aiast1/Hybrid-Solar-Thermoelectric-Power-Generation-System-with-Magneto-Hydrodynamic-Propulsion/README.md

# Hybrid-Solar-Thermoelectric-Power-Generation-System-with-Magneto-Hydrodynamic-Propulsion
Development and Evaluation of a Hybrid Solar-Thermoelectric Power Generation System with Magneto-Hydrodynamic Propulsion in a Maritime Environment
