aiast1/Hybrid-Solar-Thermoelectric-Power-Generation-System-with-Magneto-Hydrodynamic-Propulsion/Poster1b.pdf

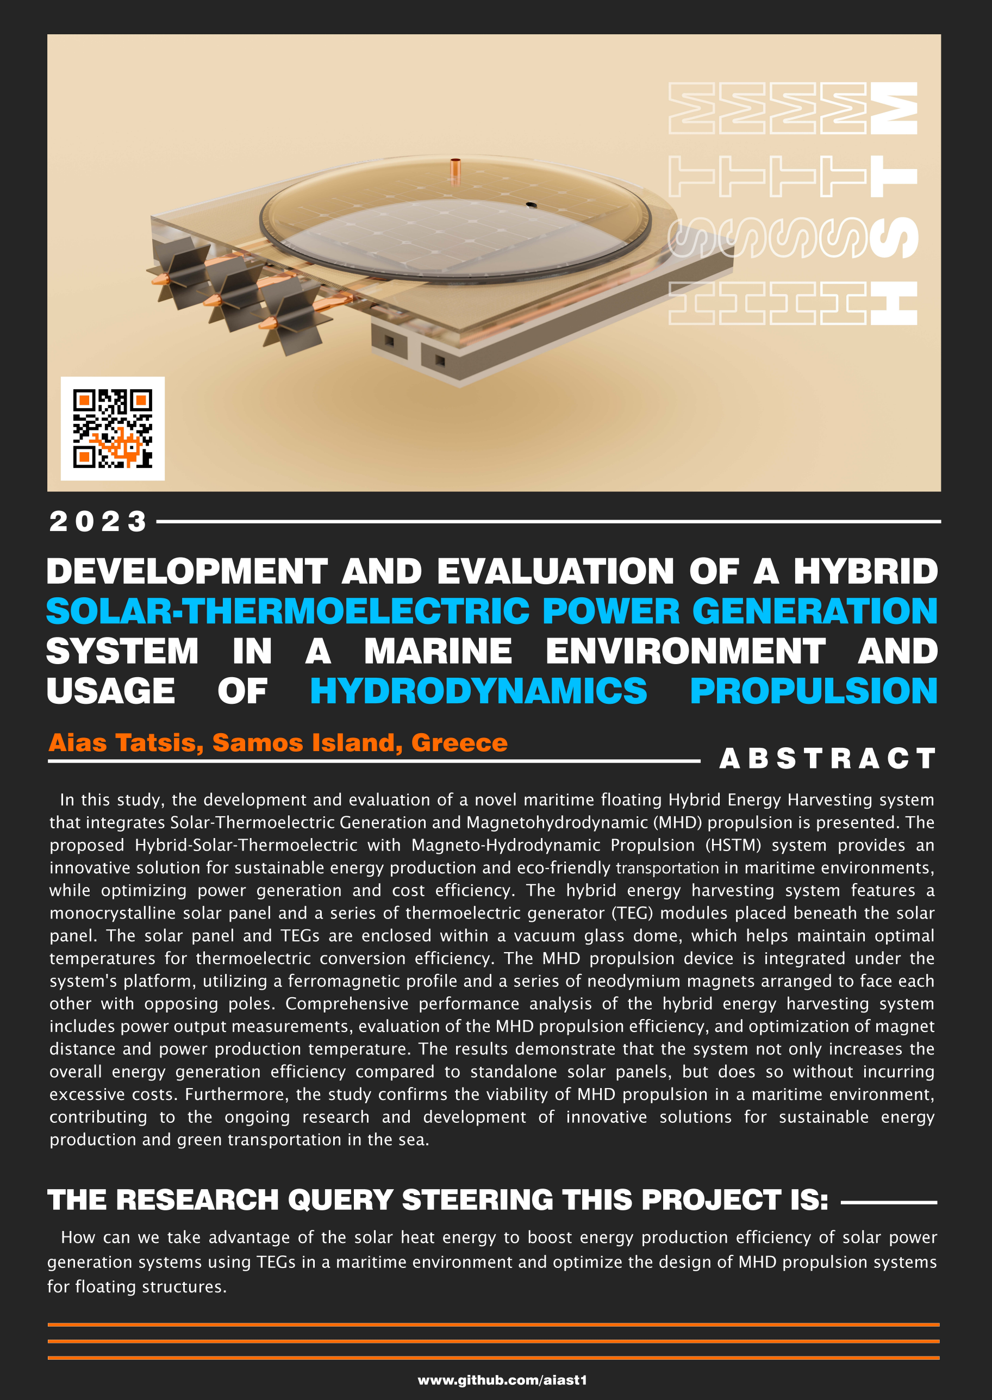
[picture p12: page 1]
