aiast1/Hybrid-Solar-Thermoelectric-Power-Generation-System-with-Magneto-Hydrodynamic-Propulsion/cad/eucys1.pdf

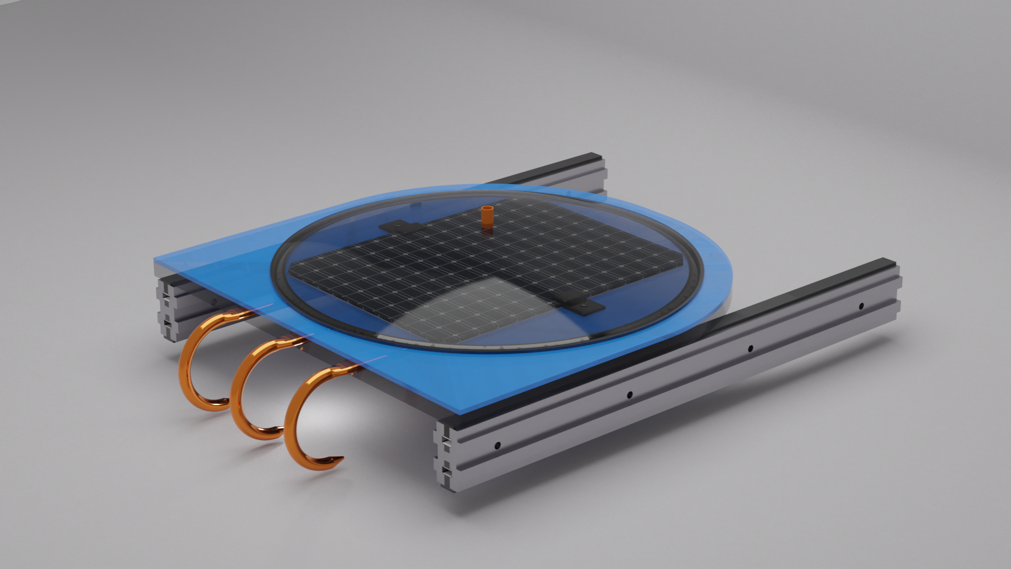
[picture p22: page 1]
