aiast1/Hybrid-Solar-Thermoelectric-Power-Generation-System-with-Magneto-Hydrodynamic-Propulsion/abstract/ABSTRACTS1.jpg

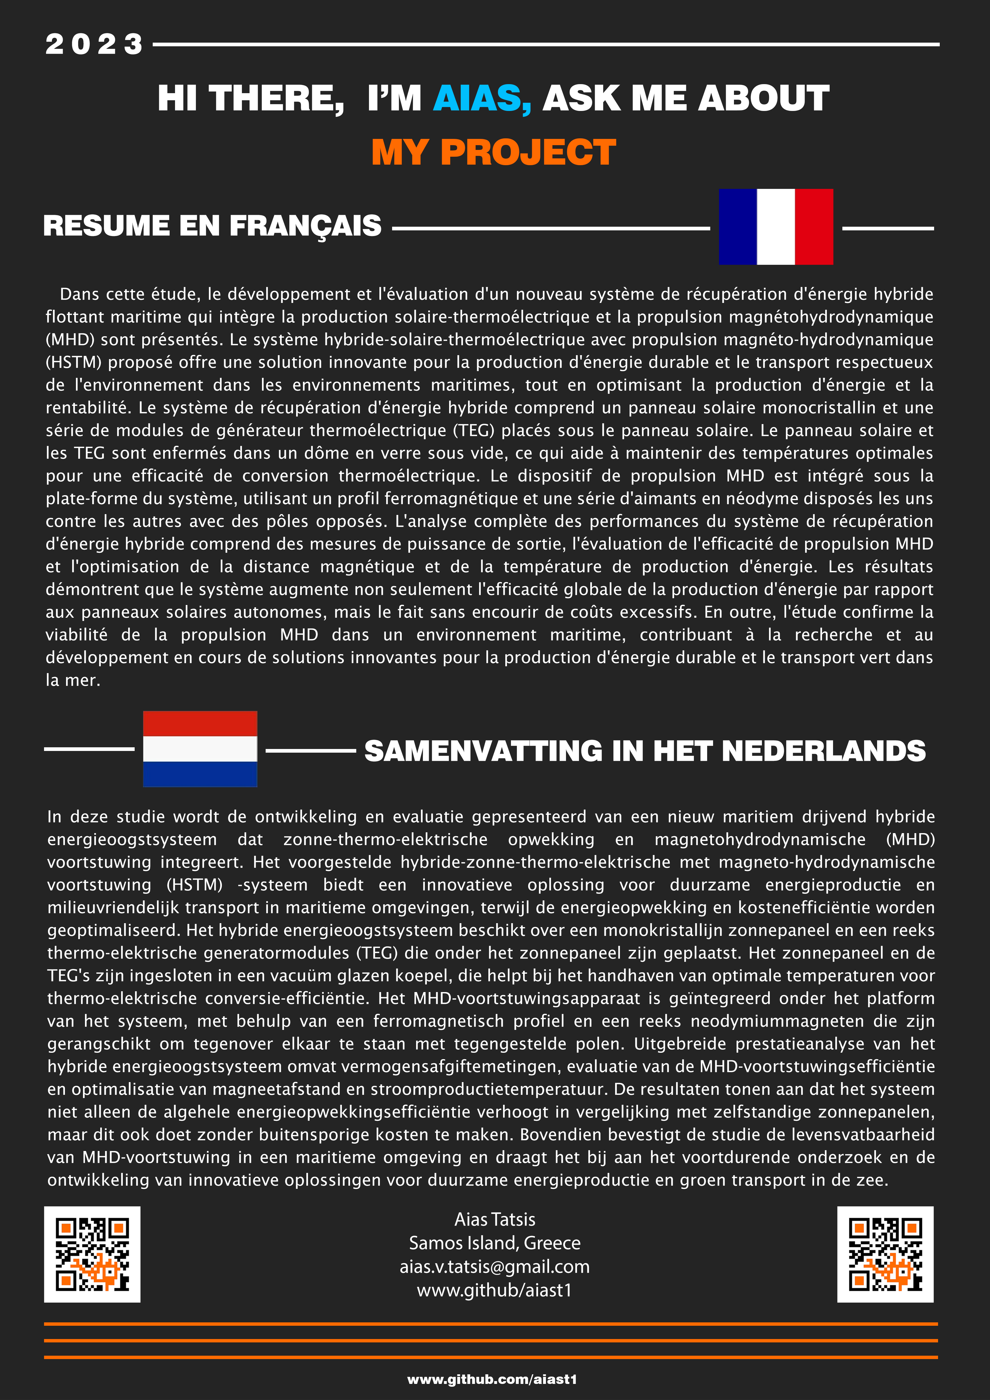
abstract/ABSTRACTS1.jpg
