aiast1/Hybrid-Solar-Thermoelectric-Power-Generation-System-with-Magneto-Hydrodynamic-Propulsion/abstract/ABSTRACTS2.jpg

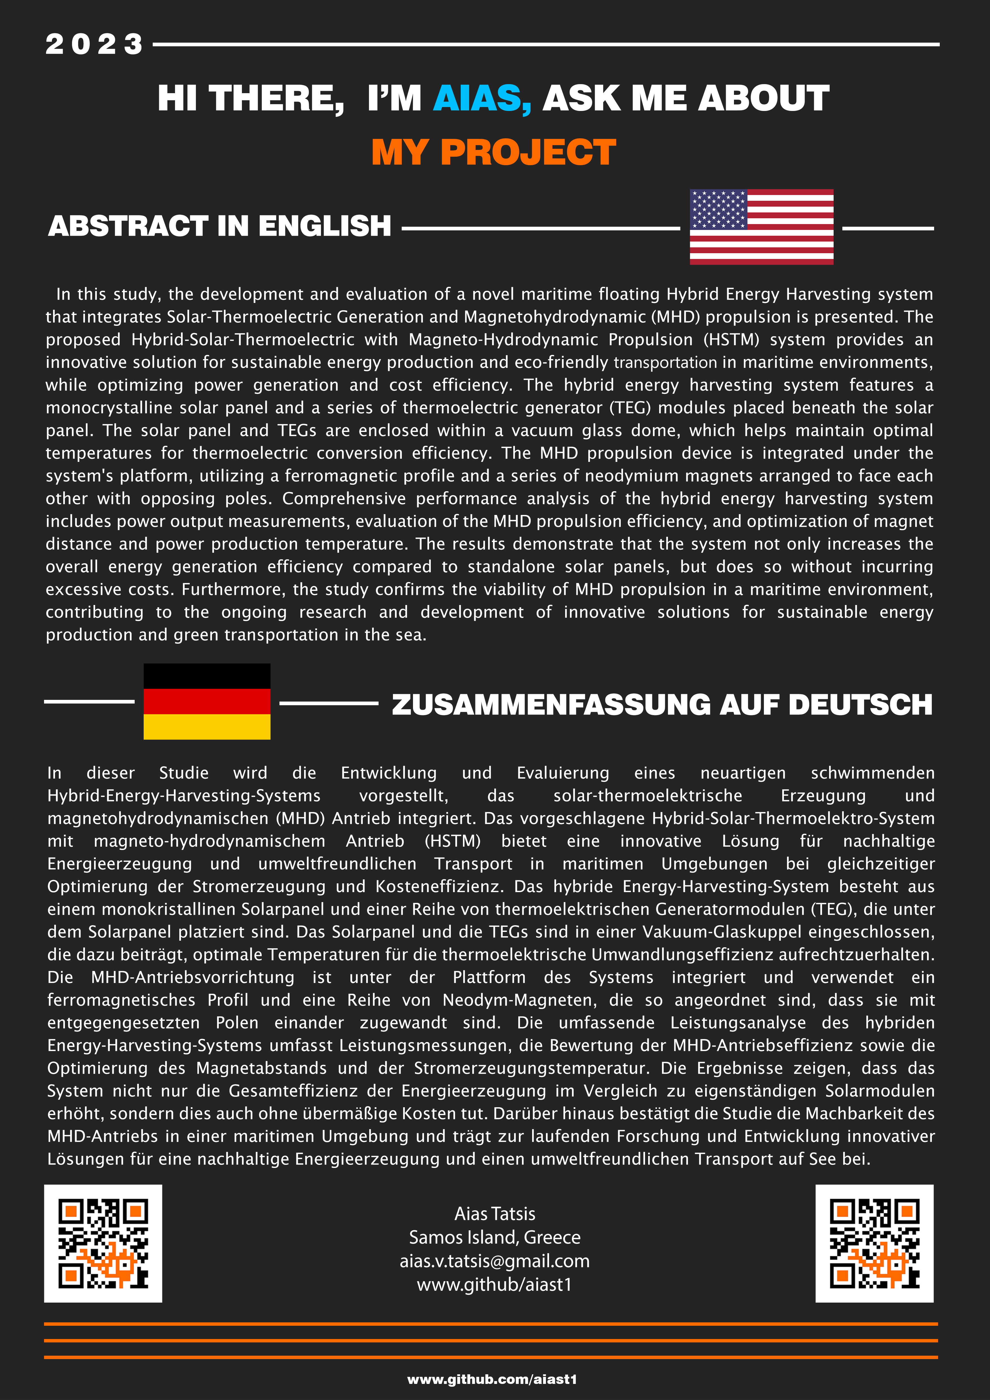
abstract/ABSTRACTS2.jpg
