aiast1/Hybrid-Solar-Thermoelectric-Power-Generation-System-with-Magneto-Hydrodynamic-Propulsion/cad/magneto_1680695830.jpg

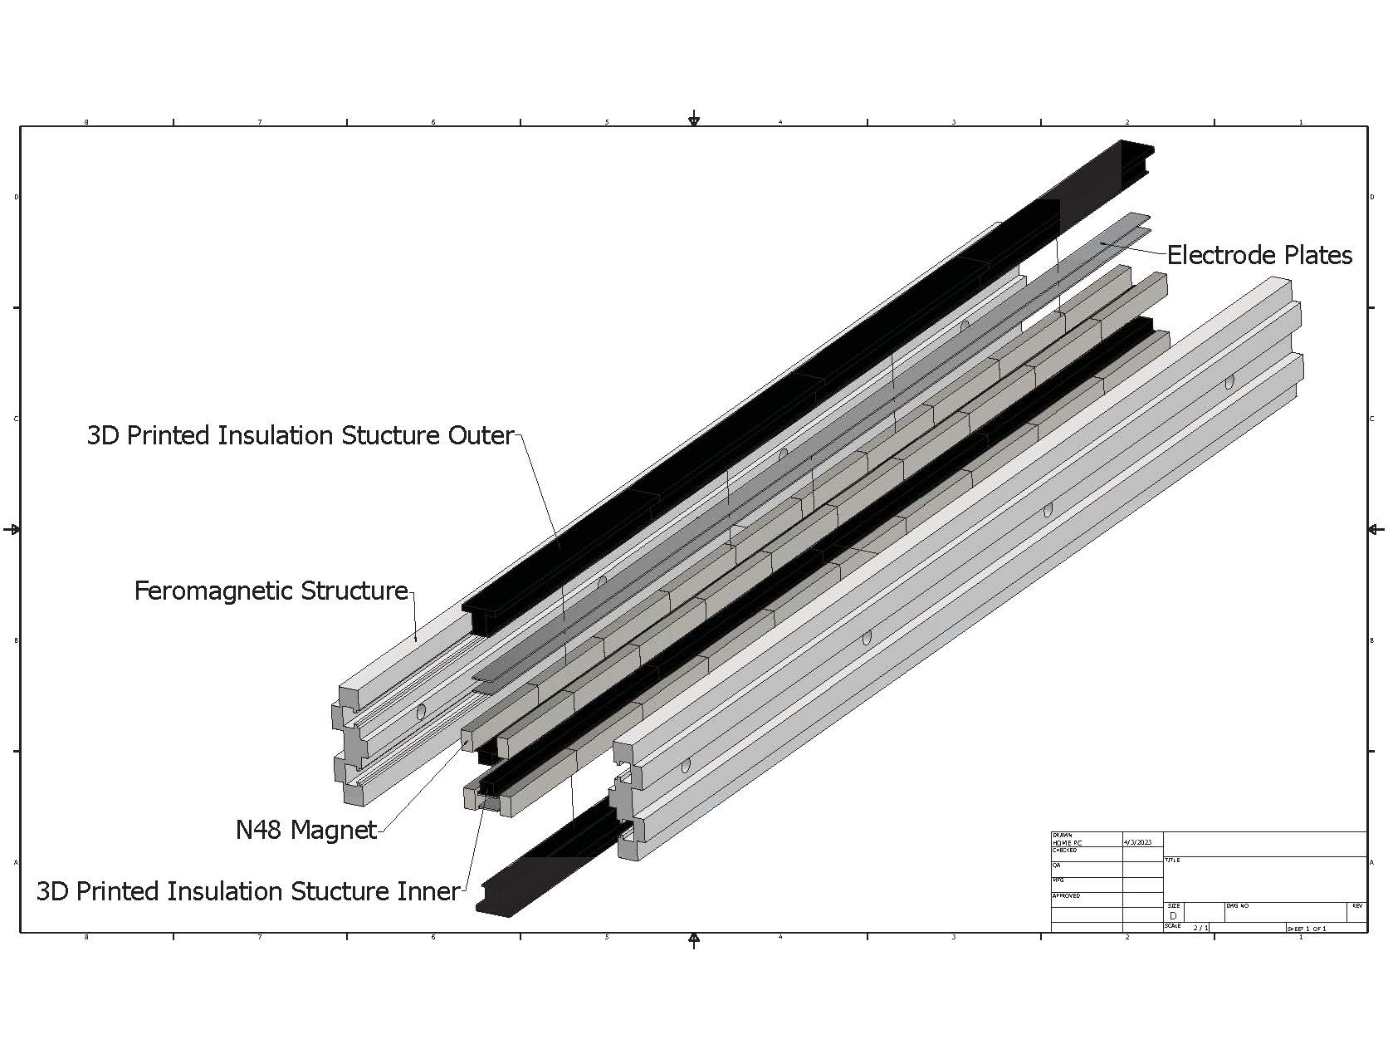
cad/magneto_1680695830.jpg
