aiast1/Hybrid-Solar-Thermoelectric-Power-Generation-System-with-Magneto-Hydrodynamic-Propulsion/efficiency heatpipes sink.png

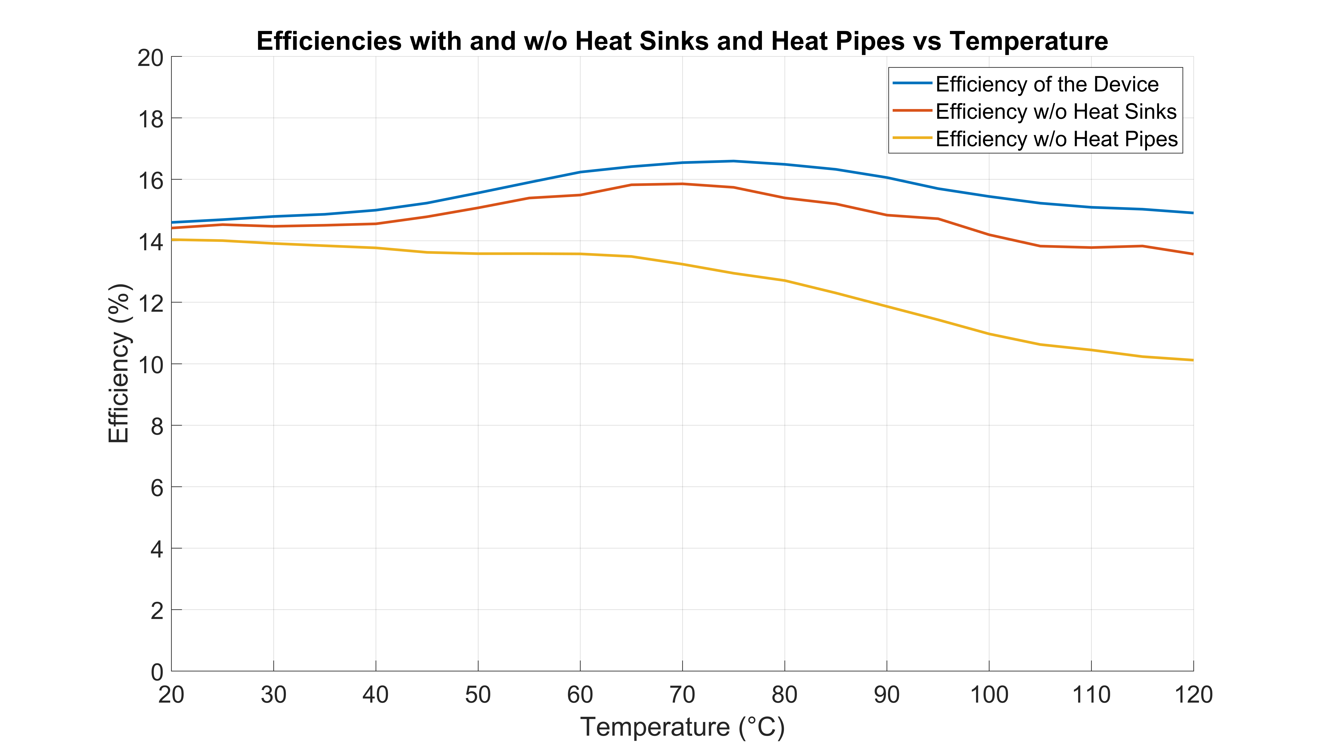
efficiency heatpipes sink.png
