aiast1/Hybrid-Solar-Thermoelectric-Power-Generation-System-with-Magneto-Hydrodynamic-Propulsion/photos/CAD/IMG_20230319_111036.jpg

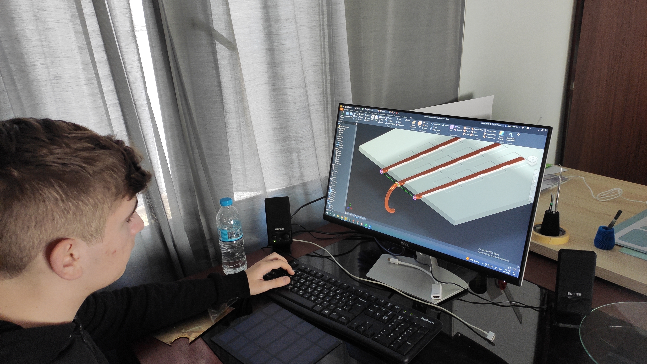
photos/CAD/IMG_20230319_111036.jpg
