aiast1/Hybrid-Solar-Thermoelectric-Power-Generation-System-with-Magneto-Hydrodynamic-Propulsion/photos/IMG_20230312_101846.jpg

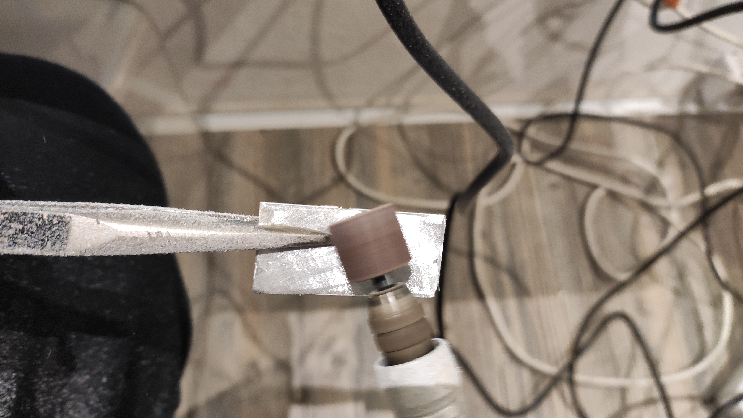
photos/IMG_20230312_101846.jpg
