aiast1/Hybrid-Solar-Thermoelectric-Power-Generation-System-with-Magneto-Hydrodynamic-Propulsion/photos/IMG_20230312_110155.jpg

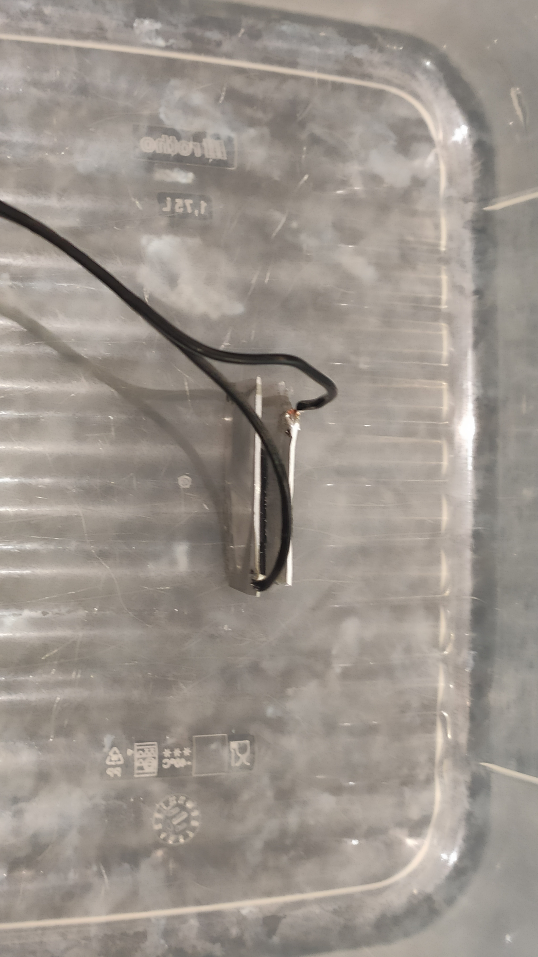
photos/IMG_20230312_110155.jpg
