aiast1/Hybrid-Solar-Thermoelectric-Power-Generation-System-with-Magneto-Hydrodynamic-Propulsion/photos/IMG_20230318_114442_1.jpg

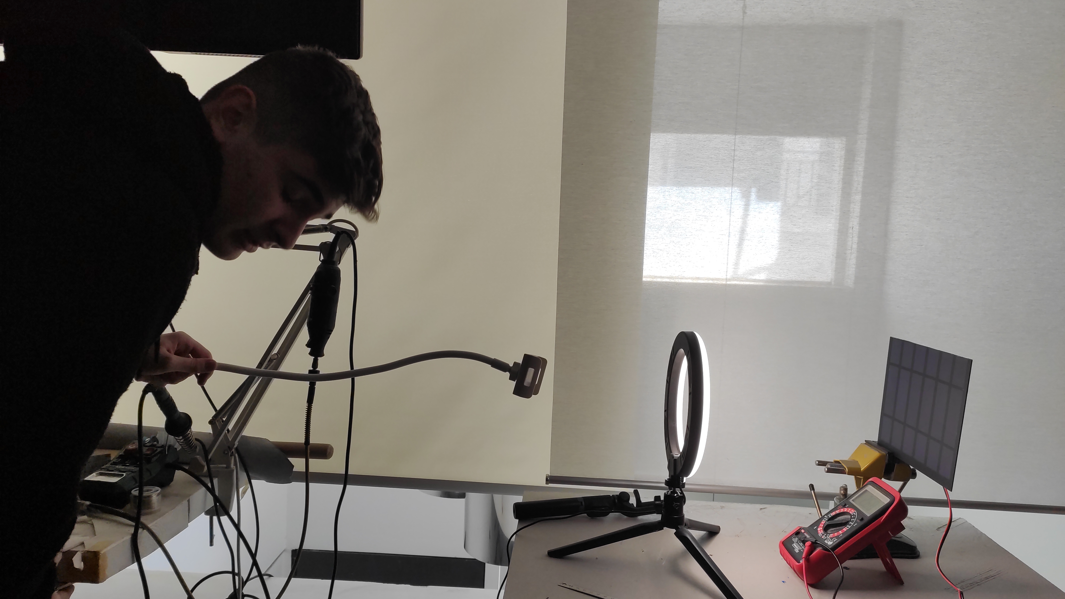
photos/IMG_20230318_114442_1.jpg
