aiast1/Hybrid-Solar-Thermoelectric-Power-Generation-System-with-Magneto-Hydrodynamic-Propulsion/speed vs voltage.PNG

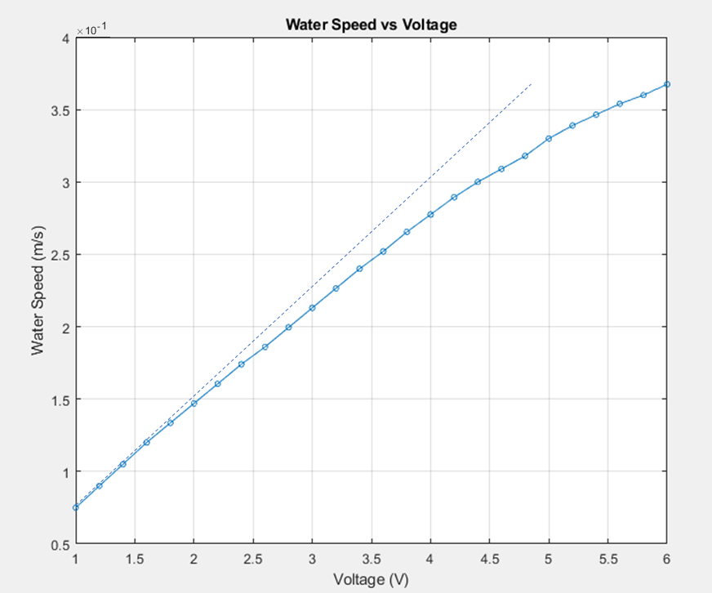
speed vs voltage.PNG
