aiast1/Hybrid-Solar-Thermoelectric-Power-Generation-System-with-Magneto-Hydrodynamic-Propulsion/TEG vs T vs Solar.png

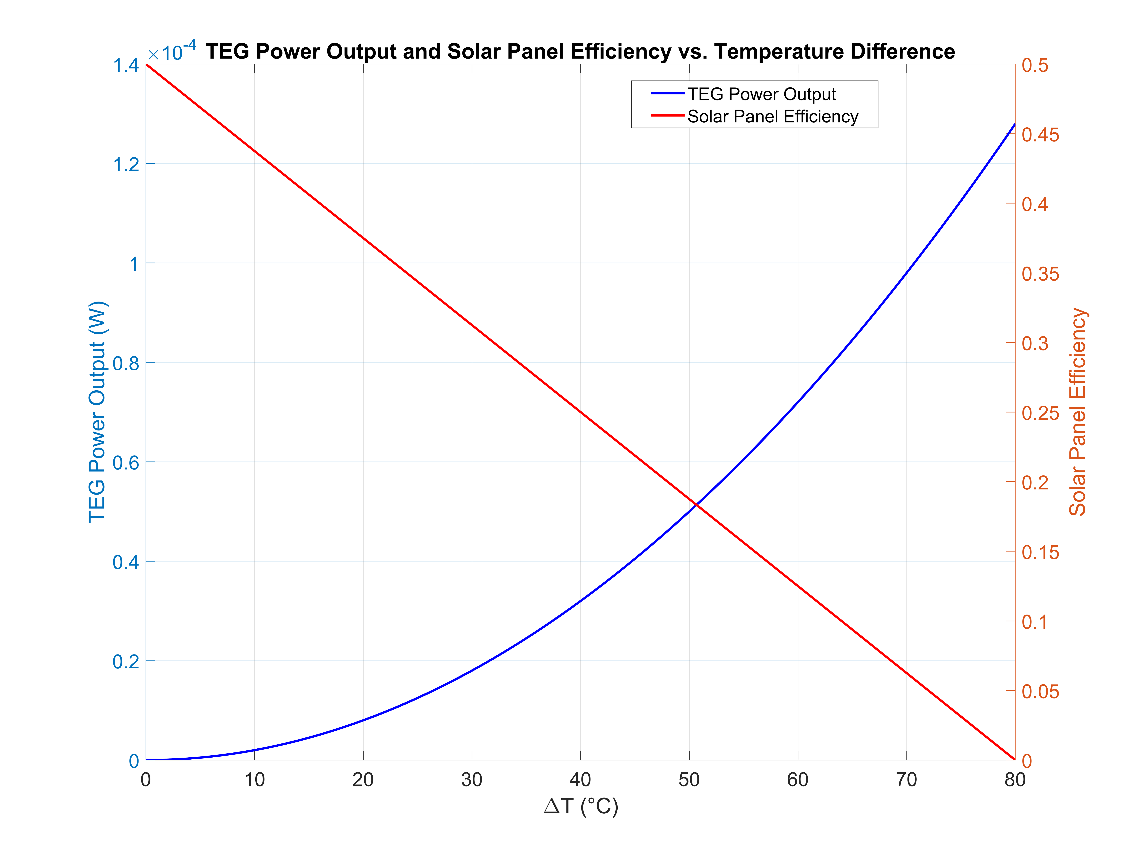
TEG vs T vs Solar.png
