aiast1/Hybrid-Solar-Thermoelectric-Power-Generation-System-with-Magneto-Hydrodynamic-Propulsion/cad/magnets nest half.stl

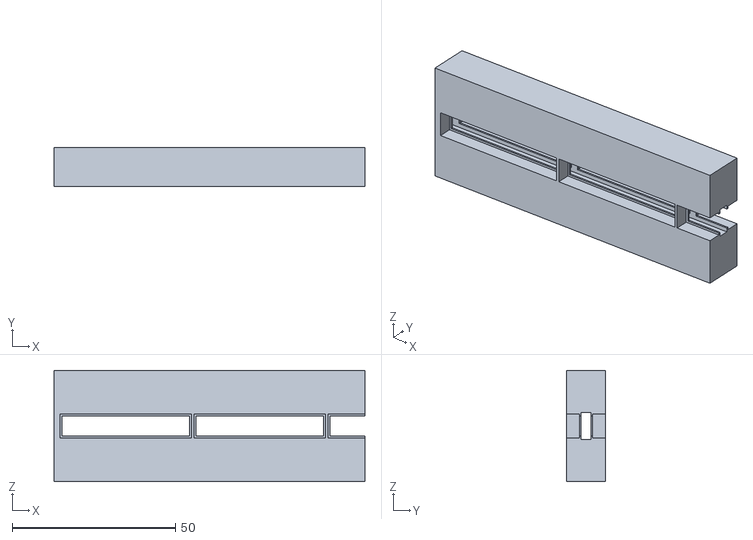
[picture p67: CAD file, 2023-09-13]
cad/magnets nest half.stl
95.2 x 12.0 x 34.0
