aiast1/Hybrid-Solar-Thermoelectric-Power-Generation-System-with-Magneto-Hydrodynamic-Propulsion/(list of files, cad)

Other CAD files:
cad/PLEXI 10 MM 3.dwg
cad/STEG.ipt
cad/magnets nest half.ipt
cad/magnets nest.ipt
