aiast1/Hybrid-Solar-Thermoelectric-Power-Generation-System-with-Magneto-Hydrodynamic-Propulsion/photos/assembly/IMG_20230330_202559.jpg

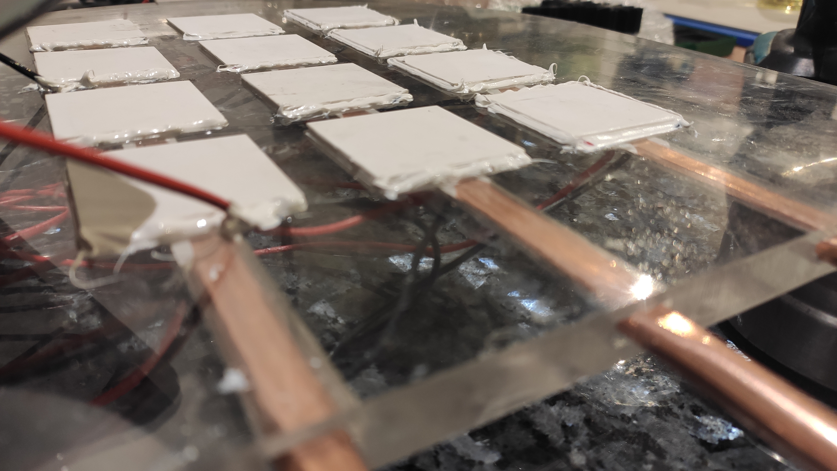
photos/assembly/IMG_20230330_202559.jpg
