aiast1/Hybrid-Solar-Thermoelectric-Power-Generation-System-with-Magneto-Hydrodynamic-Propulsion/photos/assembly/IMG_20230401_193739.jpg

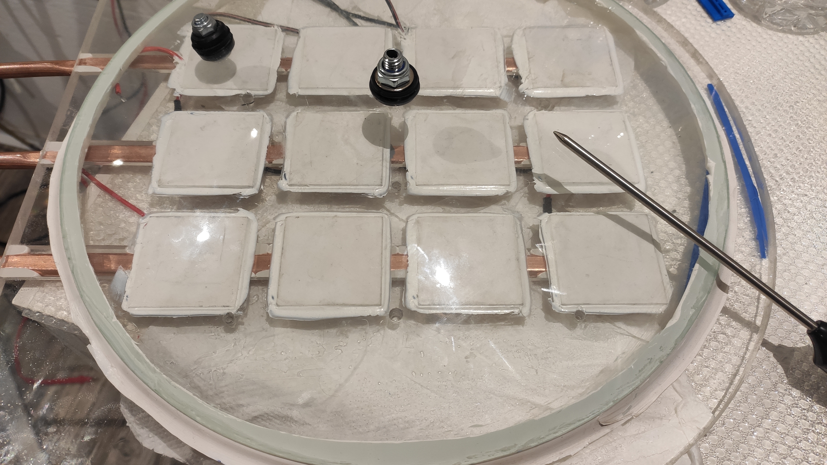
photos/assembly/IMG_20230401_193739.jpg
