aiast1/Hybrid-Solar-Thermoelectric-Power-Generation-System-with-Magneto-Hydrodynamic-Propulsion/photos/construction/IMG_20230328_185858.jpg

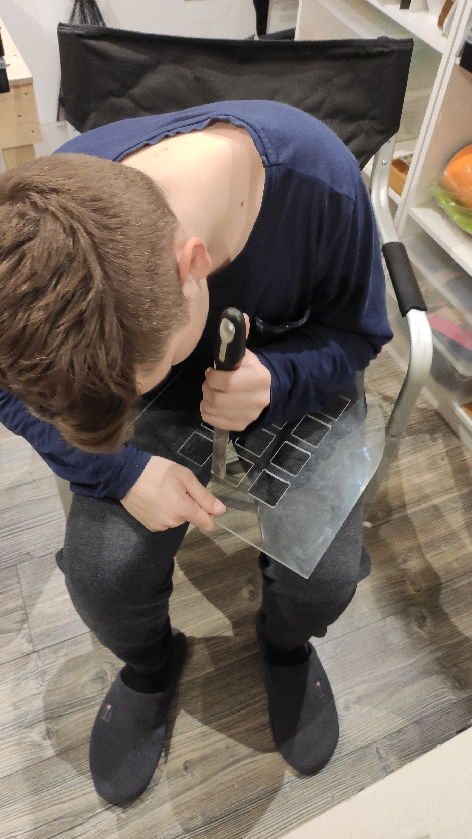
photos/construction/IMG_20230328_185858.jpg
