aiast1/Hybrid-Solar-Thermoelectric-Power-Generation-System-with-Magneto-Hydrodynamic-Propulsion/photos/construction/IMG_20230330_120338.jpg

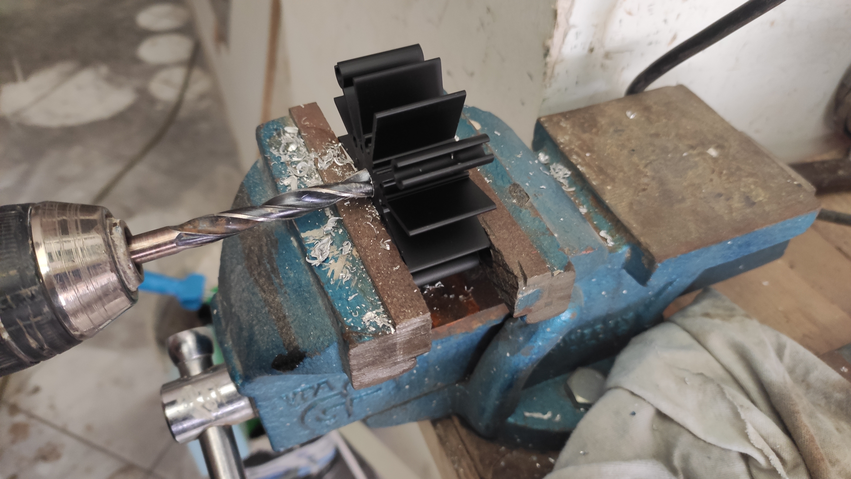
photos/construction/IMG_20230330_120338.jpg
