aiast1/Hybrid-Solar-Thermoelectric-Power-Generation-System-with-Magneto-Hydrodynamic-Propulsion/photos/testing/IMG_20230430_141038 - Copy.jpg

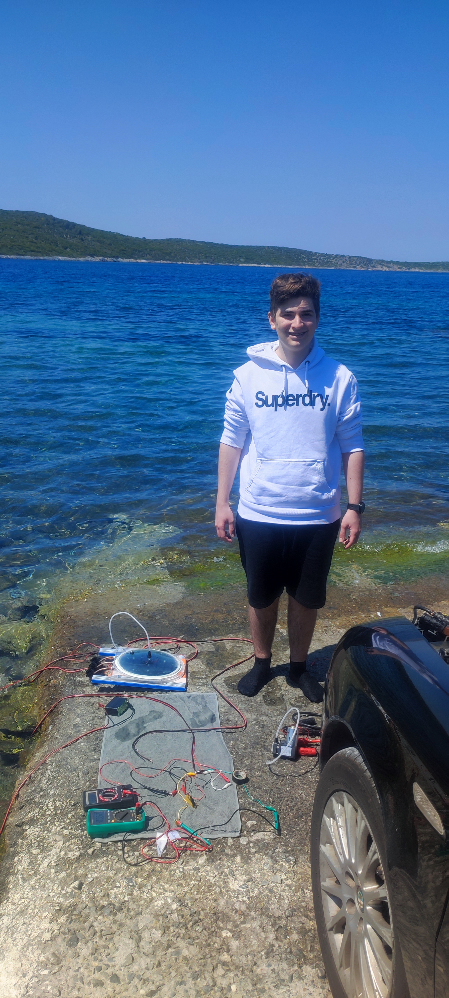
photos/testing/IMG_20230430_141038 - Copy.jpg
