aiast1/Hybrid-Solar-Thermoelectric-Power-Generation-System-with-Magneto-Hydrodynamic-Propulsion/cad/project design.pdf

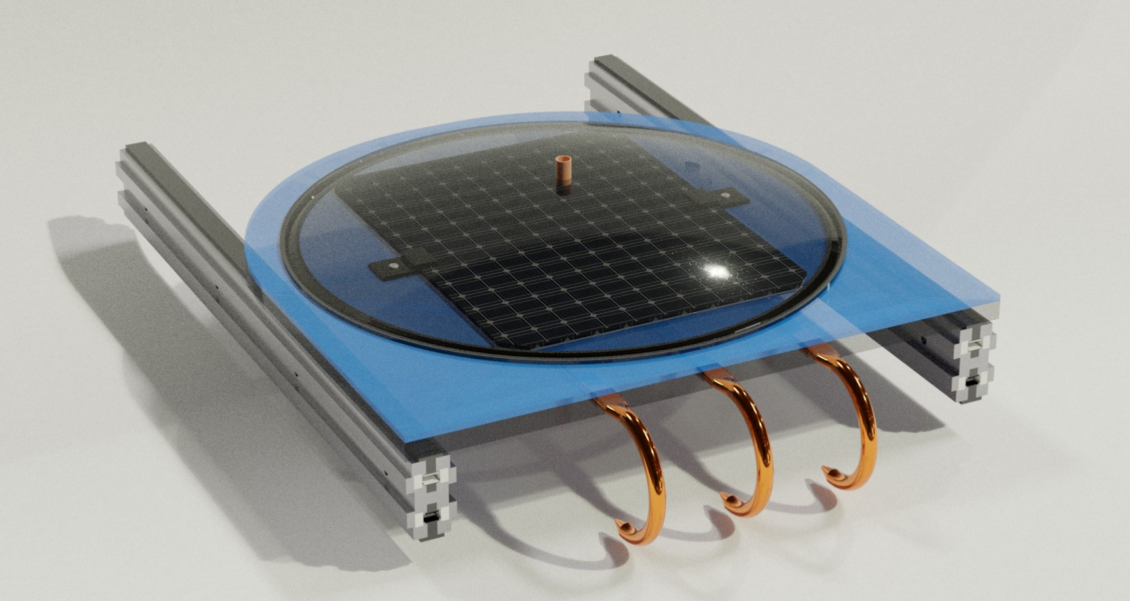
[picture p120: page 1]
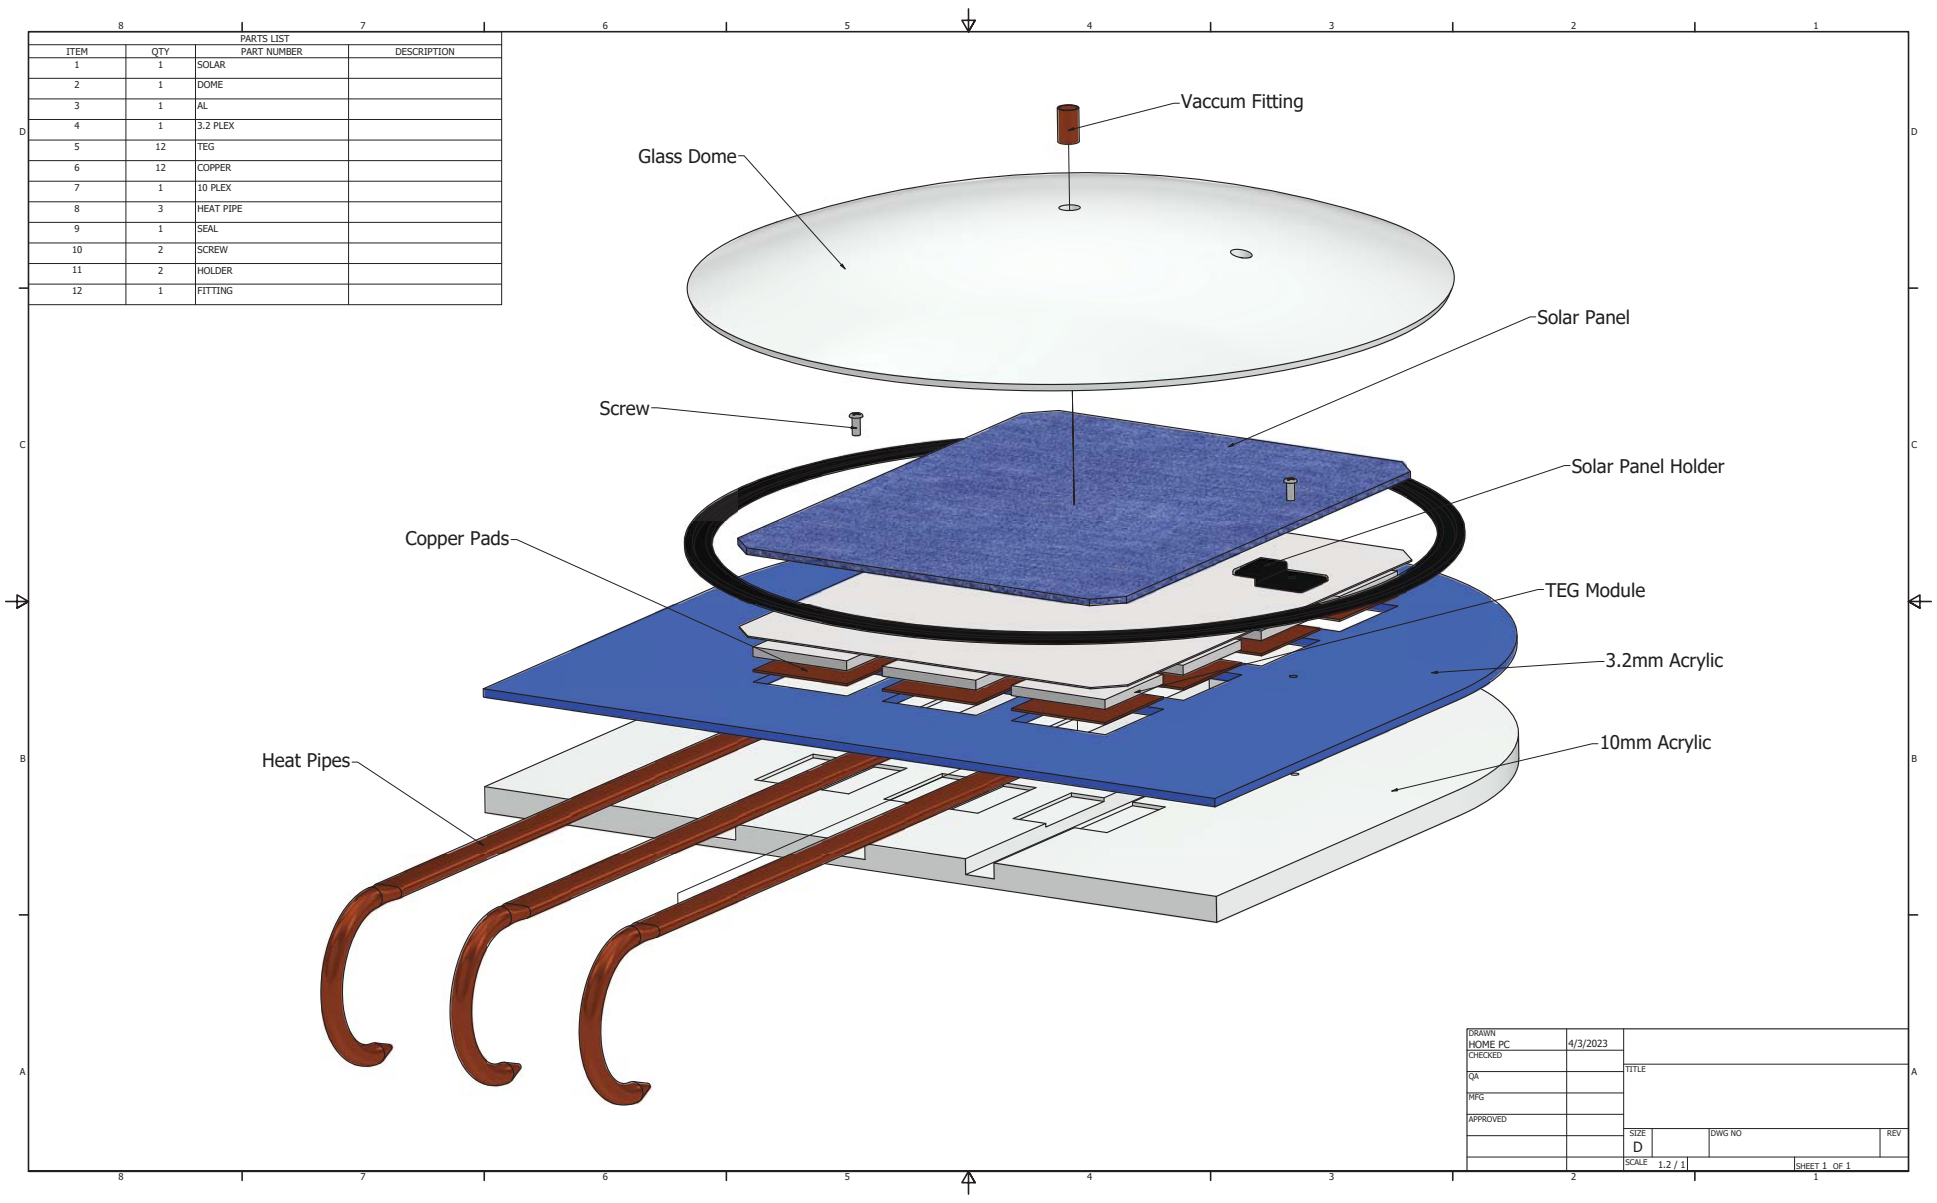
[picture p121: page 2]
PARTS LIST; ITEM; QTY; PART NUMBER; DESCRIPTION; SOLAR; DOME; 3.2 PLEX; TEG; COPPER; 10 PLEX; HEAT PIPE; SEAL; SCREW; HOLDER; FITTING; SHEET 1 OF 1; DRAWN; CHECKED; MFG; APPROVED; HOME PC; DWG NO; TITLE; SIZE D; SCALE; REV; Glass Dome; Vaccum Fitting; Screw; Solar Panel; Copper Pads; TEG Module; 3.2mm Acrylic; 10mm Acrylic; Heat Pipes

Solar Panel Holder

# Electrode Plates

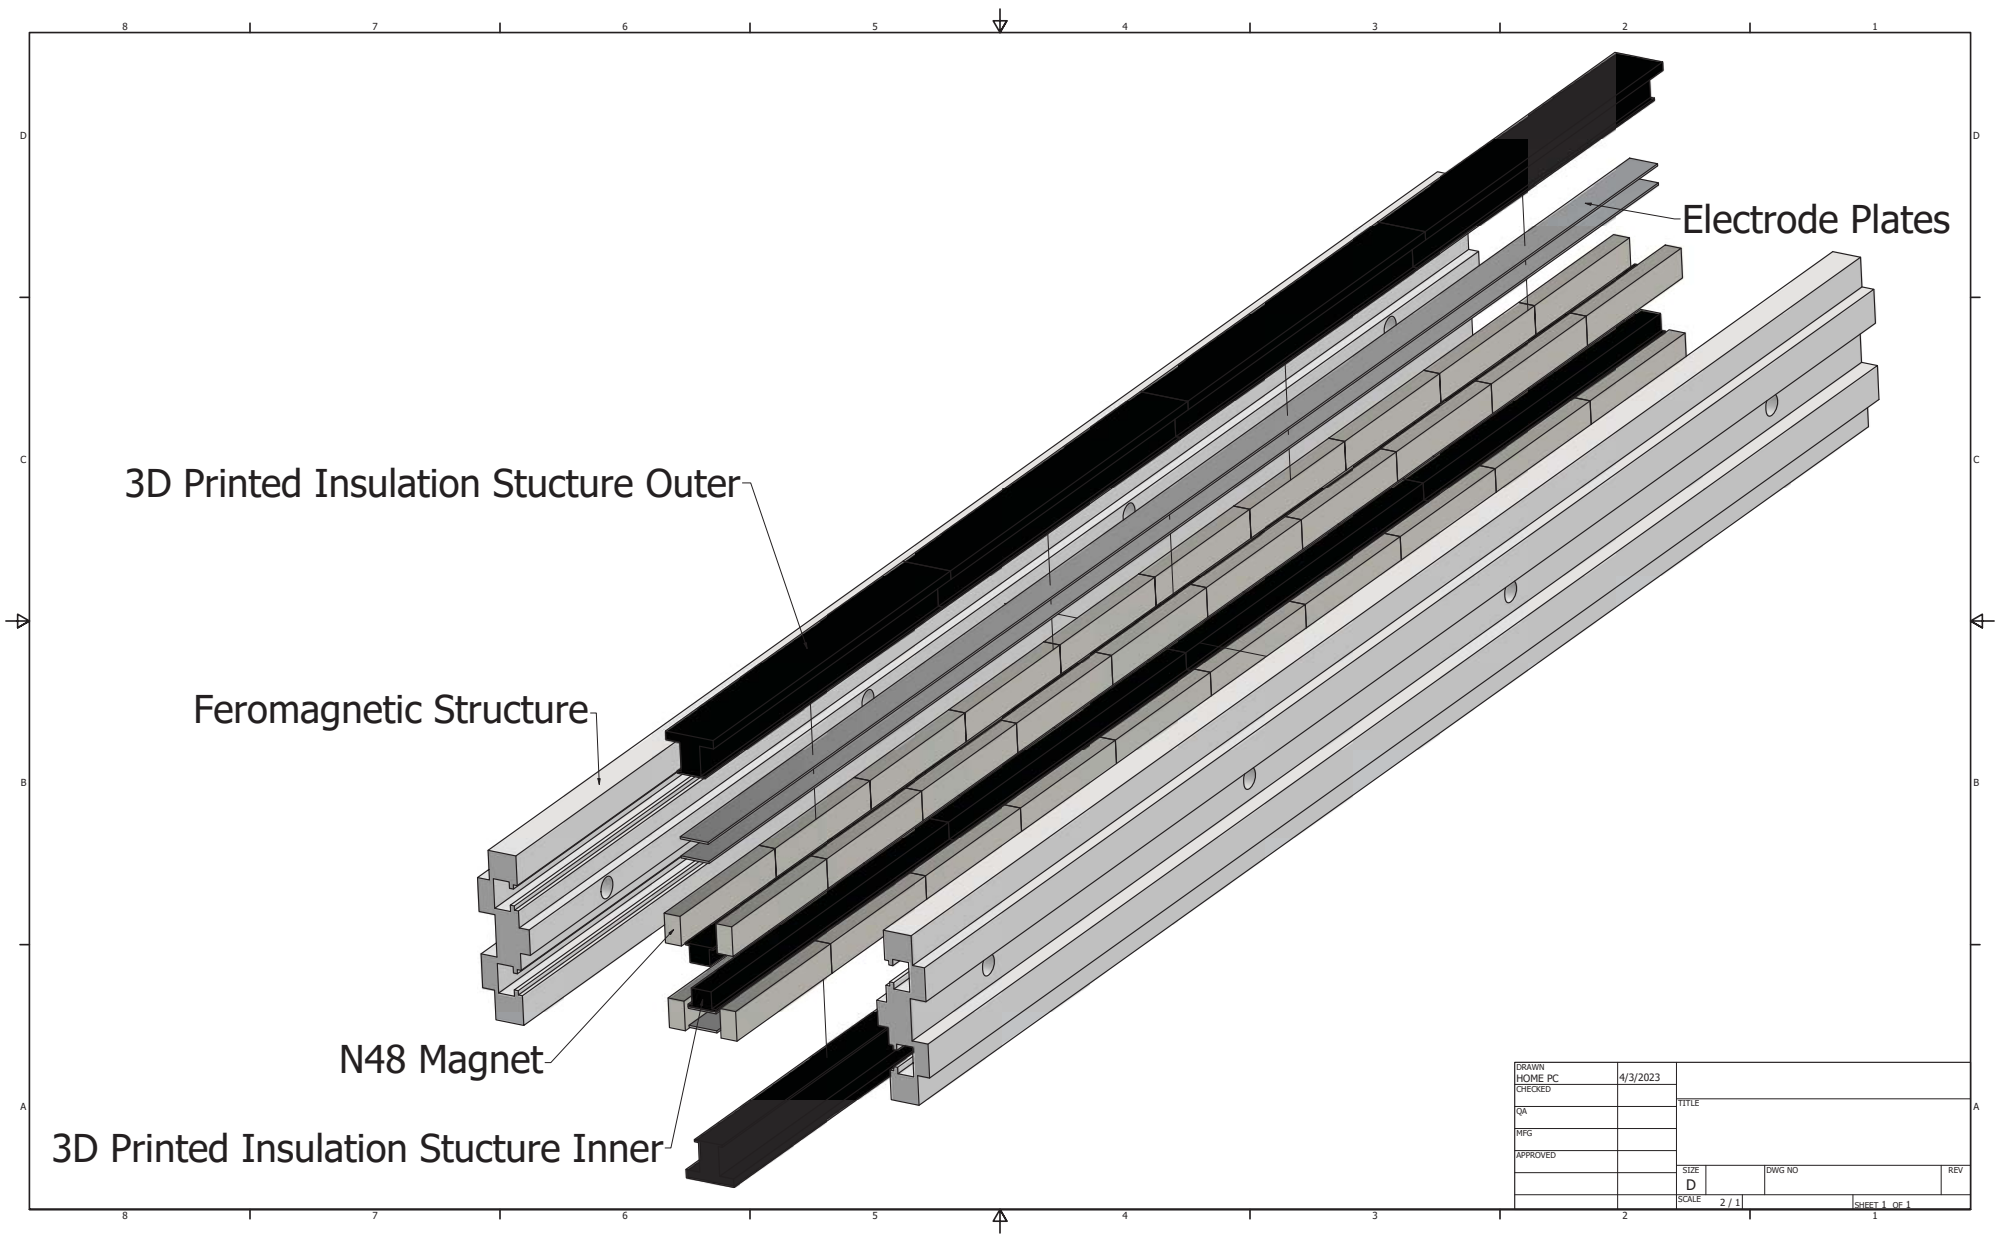
[picture p122: page 3]
SHEET 1 OF 1; DRAWN; CHECKED; MFG; APPROVED; HOME PC; DWG NO; TITLE; SIZE D; SCALE; REV; Feromagnetic Structure; N48 Magnet

3D Printed Insulation Stucture Outer

3D Printed Insulation Stucture Inner

320,00

1,80

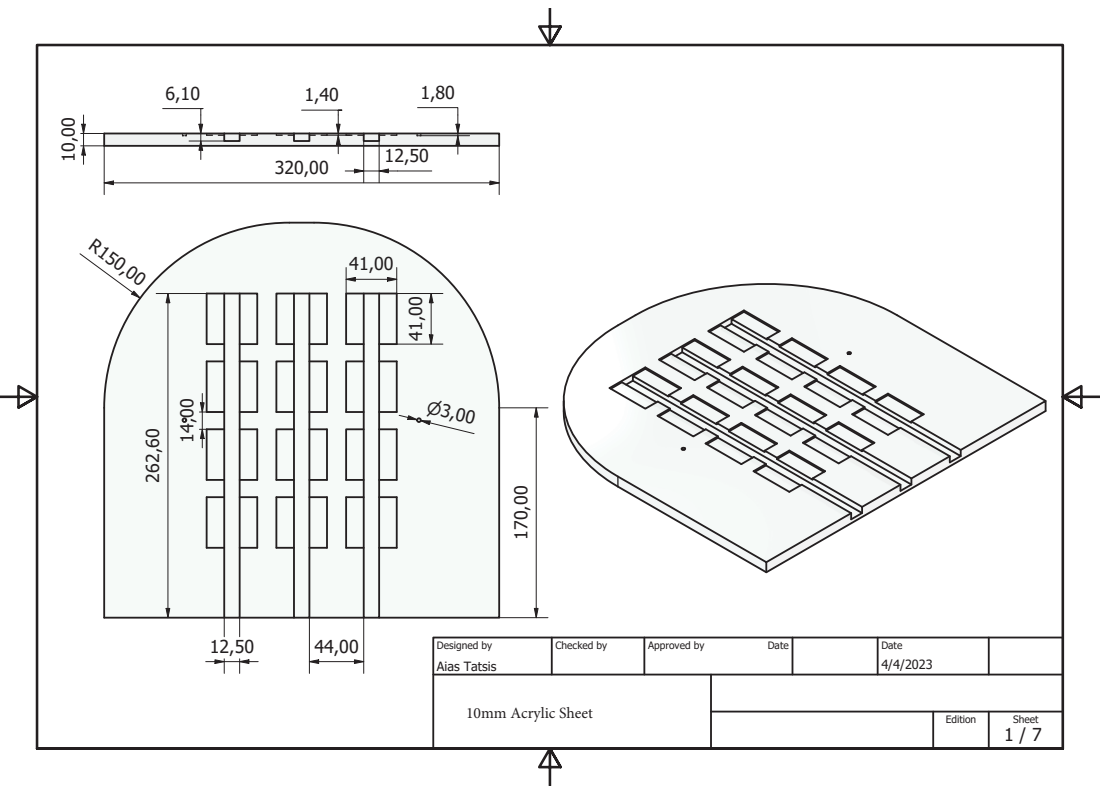
[picture p123: page 4]
Aias Tatsis; Designed by; Checked by; Approved by; Date; Edition; Sheet; 10mm Acrylic Sheet

41,00 | R150,00

20,00

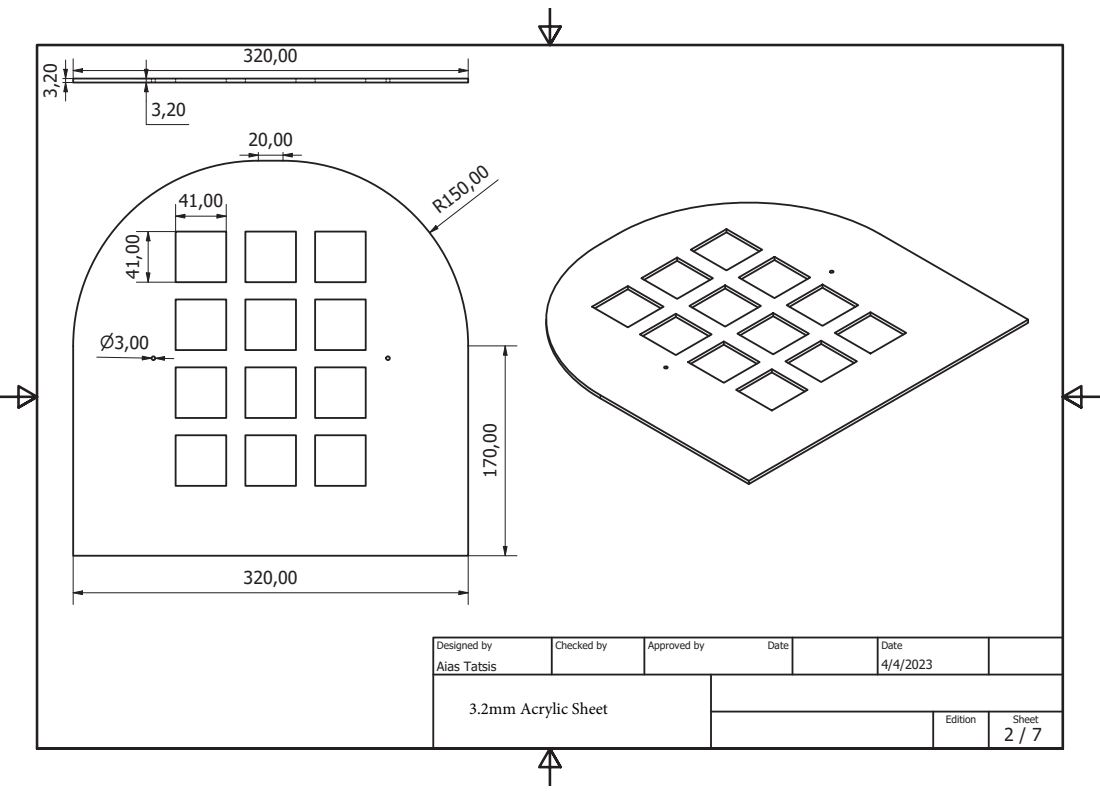
[picture p124: page 5]
Aias Tatsis; Designed by; Checked by; Approved by; Date; Edition; Sheet; 3.2mm Acrylic Sheet

P282,65

1,17

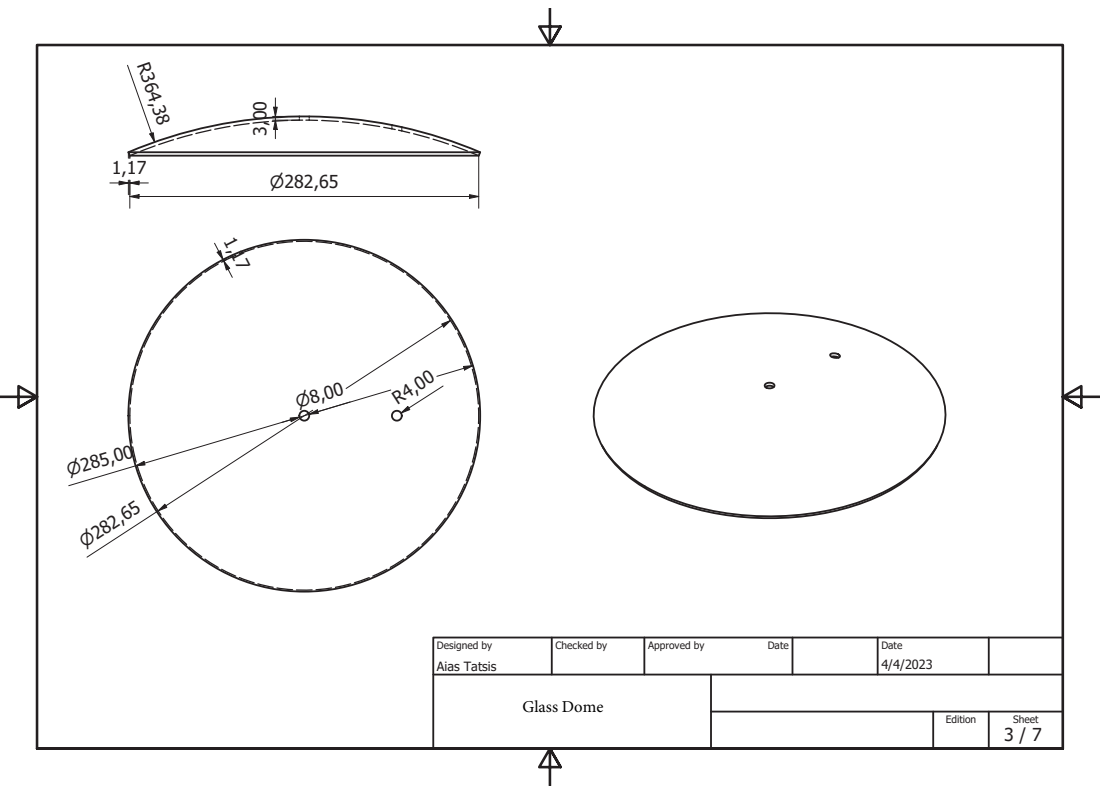
[picture p125: page 6]
Aias Tatsis; Designed by; Checked by; Approved by; Date; Edition; Sheet; Glass Dome

6,79

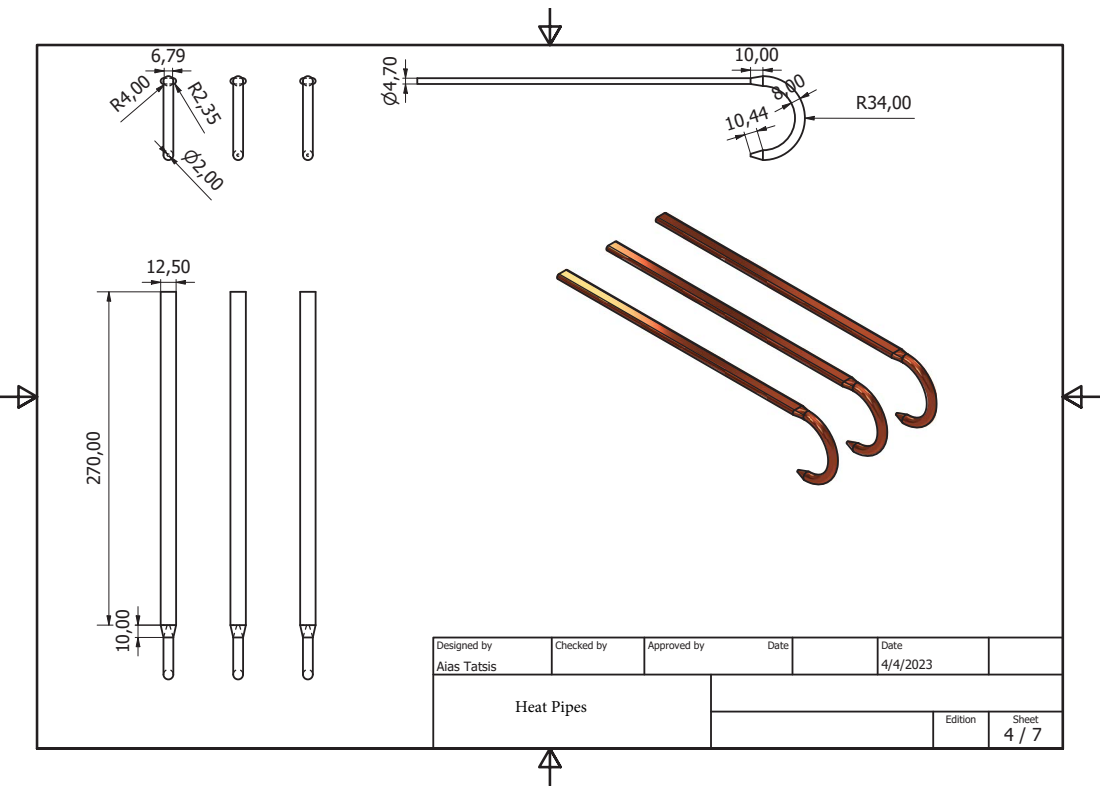
[picture p126: page 7]
Aias Tatsis; Designed by; Checked by; Approved by; Date; Edition; Sheet; Heat Pipes

41,00

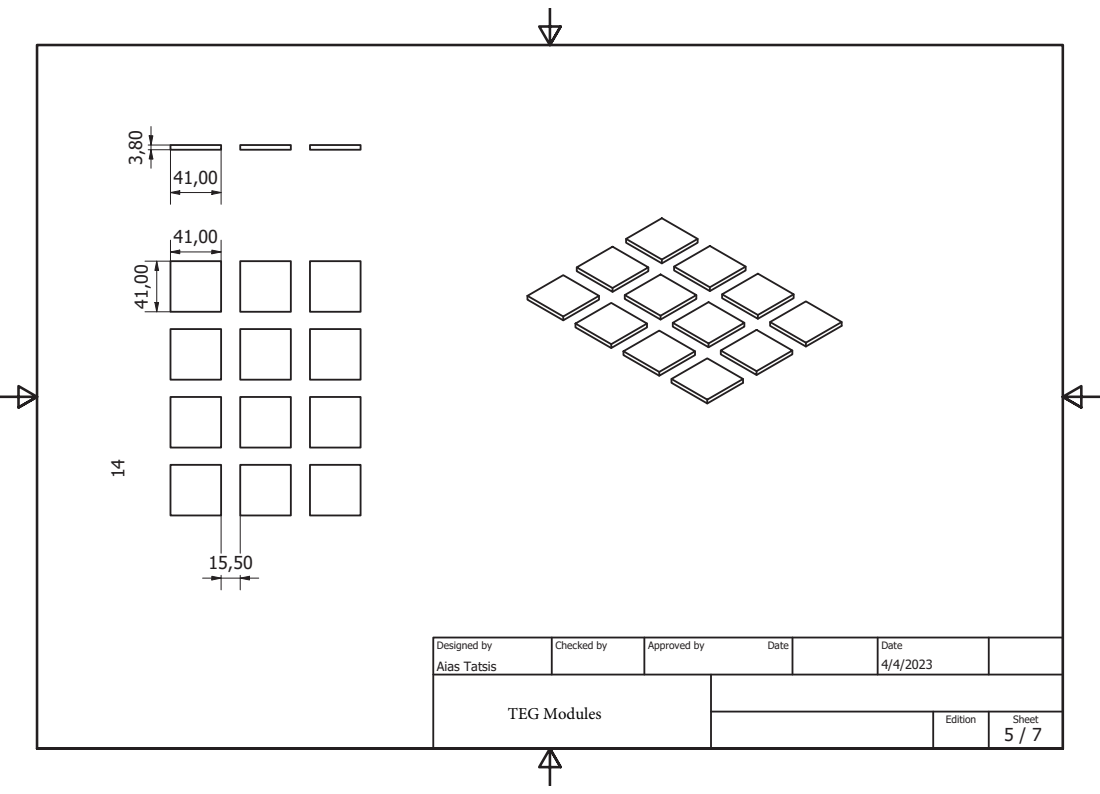
[picture p127: page 8]
Aias Tatsis; Designed by; Checked by; Approved by; Date; Edition; Sheet; TEG Modules

12,00 2,00

8,00 7,00

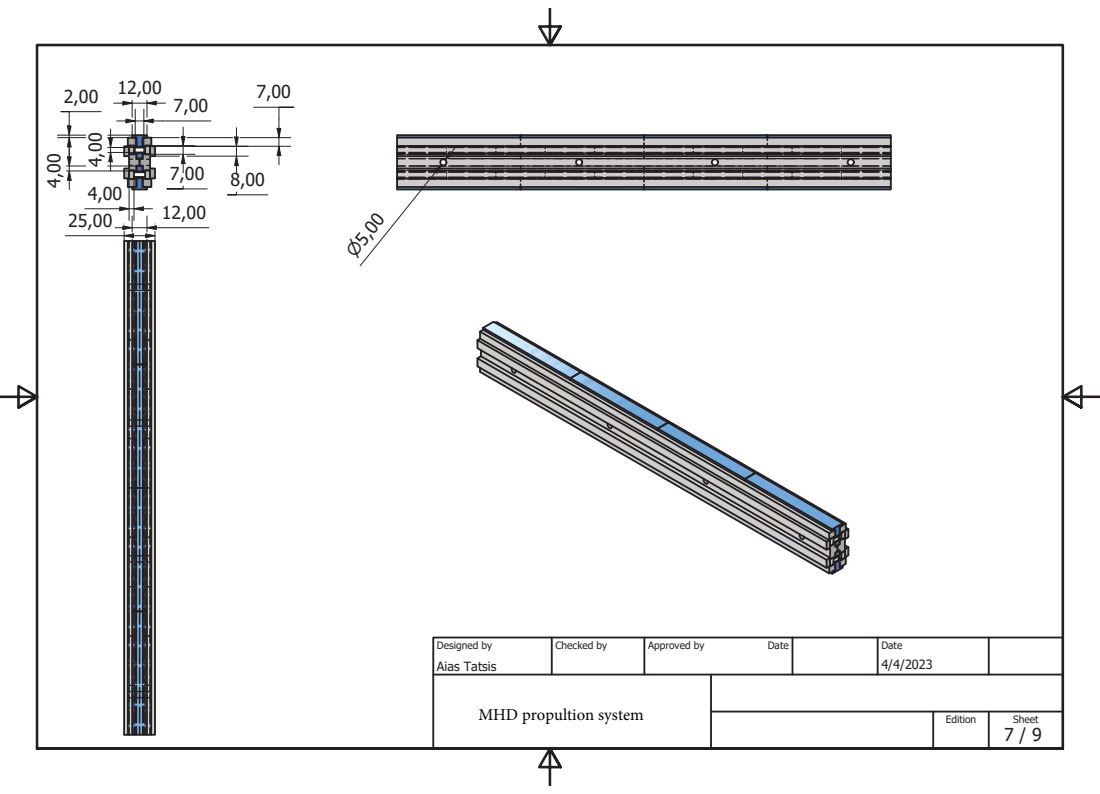
[picture p128: page 9]
Aias Tatsis; Designed by; Checked by; Approved by; Date; Edition; Sheet

MHD propultion system
