aiast1/Hybrid-Solar-Thermoelectric-Power-Generation-System-with-Magneto-Hydrodynamic-Propulsion/cad/STEG.pdf

Glass Dome; Vaccum Fitting; Solar Panel; Copper Pads; TEG Module; 3.2mm Acrylic; 10mm Acrylic; Heat Pipes

PARTS LIST

ITEM | QTY | PART NUMBER | DESCRIPTION
1 | 1 | SOLAR
2 | 1 | DOME
3 | 1 | AL
4 | 1 | 3.2 PLEX
5 | 12 | TEG
6 | 12 | COPPER
7 | 1 | 10 PLEX
8 | 3 | HEAT PIPE
9 | 1 | SEAL
10 | 2 | SCREW
11 | 2 | HOLDER
12 | 1 | FITTING

Solar Panel Holder

DRAWN HOME PC | 4/3/2023

CHECKED

MFG

APPROVED

SIZE D | | DWG NO | REV

SCALE 1.2 / 1 | | SHEET 1 OF 1
