aiast1/Hybrid-Solar-Thermoelectric-Power-Generation-System-with-Magneto-Hydrodynamic-Propulsion/cad/project design6-7.pdf

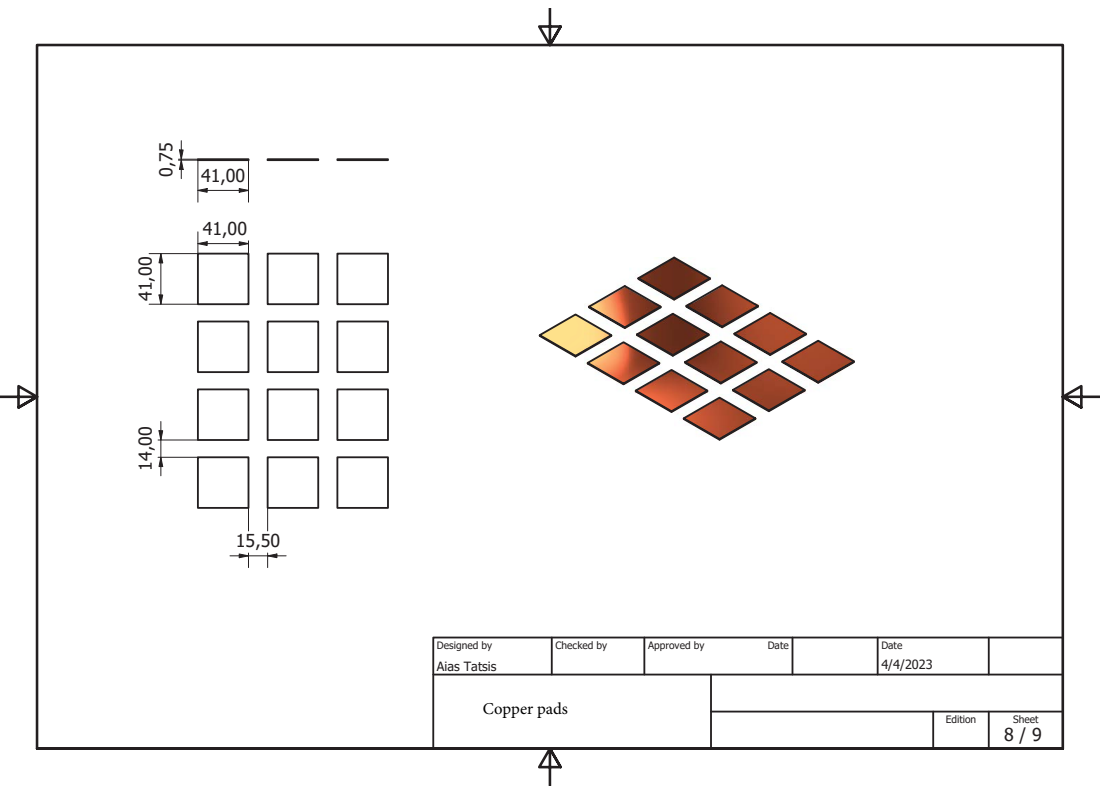
[picture p129: page 1]

Designed by Aias Tatsis | Checked by | Approved by Date | Date 4/4/2023

Copper pads

Edition | Sheet 8 / 9

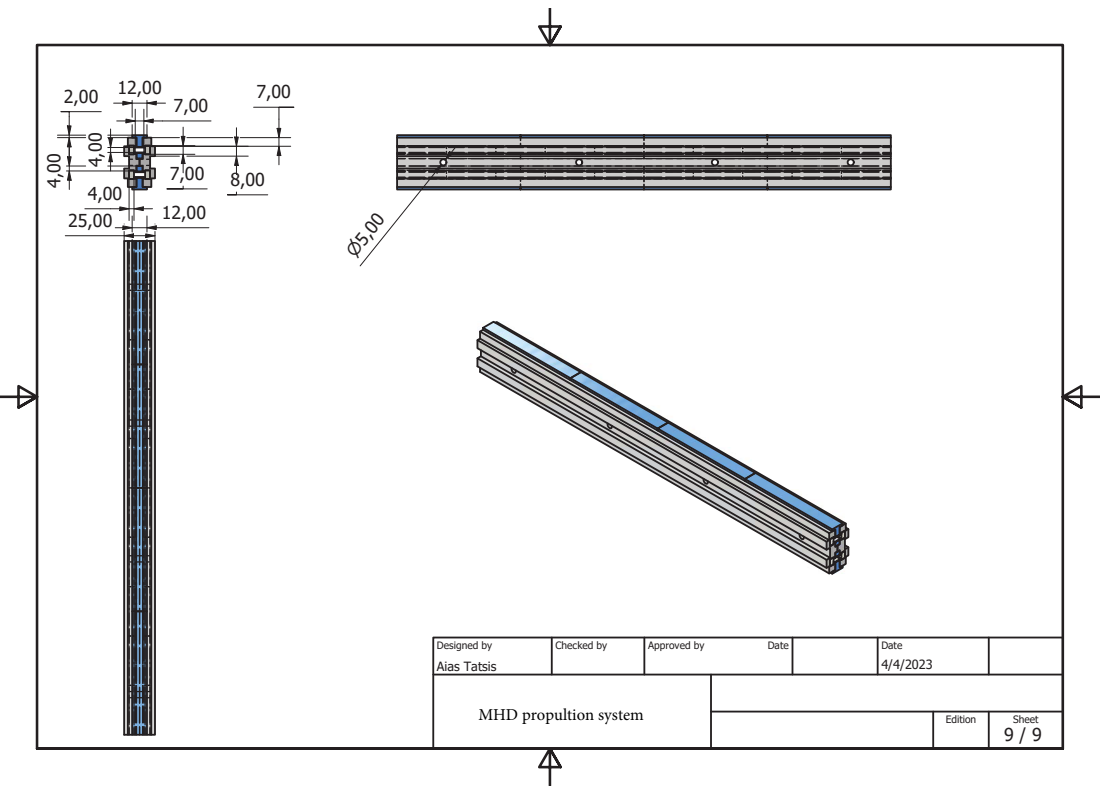
[picture p130: page 2]

Designed by Aias Tatsis | Checked by | Approved by Date | Date 4/4/2023

MHD propultion system

Edition | Sheet 9 / 9
