aiast1/Hybrid-Solar-Thermoelectric-Power-Generation-System-with-Magneto-Hydrodynamic-Propulsion/photos/testing/IMG_20230414_131345.jpg

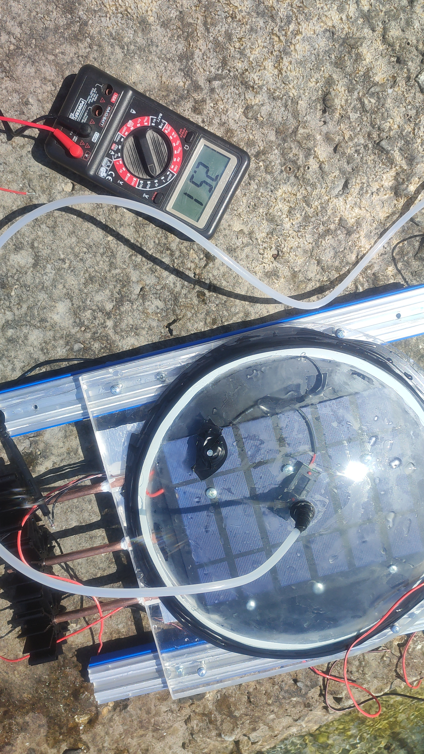
photos/testing/IMG_20230414_131345.jpg
